briandorey/10Mhz-Frequency-Standard-Distribution-Project/README.md

# 10Mhz Frequency Standard-Distribution Project
10Mhz Frequency Standard Distribution Project pcb files and firmware files.

PCB files are in Diptrace format.

Full details for this project are on my blog [http://www.briandorey.com/post/10Mhz-Frequency-Standard-Distribution-Project](http://www.briandorey.com/post/10Mhz-Frequency-Standard-Distribution-Project)
