briandorey/10Mhz-Frequency-Standard-Distribution-Project/Schematic and PCB/10Mhz Frequency Standard Bom.xlsx

Sheet: power board bom
RefDes | Value | Name | Part | Pattern | Quantity
C1 | 0.33uF |  | Part 1 | CAPAE-4.3x4.3h5.4 | 1 | http://uk.farnell.com/wurth-elektronik/865090640003/cap-alu-elec-0-33uf-50v-radial/dp/2466392
C2, C5, C6, C7, C8, C9 | 100nF |  | Part 1 | CAP_0603 | 6 | http://uk.farnell.com/tdk/cga3e2x8r1e104k080aa/cap-mlcc-x8r-100nf-25v-0603/dp/2210887
C3 | 2uF |  | Part 1 | CAPAE-4.3x4.3h5.4 | 1 | http://uk.farnell.com/wurth-elektronik/865060640002/cap-alu-elec-2-2uf-50v-radial/dp/2466227
C4 | 1uF |  | Part 1 | CAPAE-4.3x4.3h5.4 | 1 | http://uk.farnell.com/wurth-elektronik/865080640001/cap-alu-elec-1uf-50v-radial-can/dp/2466328
C10 | 10uF | C2012X5R1E106K125AB | Part 1 | CAP_0805 | 1 | http://uk.farnell.com/tdk/c2012x5r1e106k125ab/cap-mlcc-x5r-10uf-25v-0805/dp/2346927
C11 | 1uF |  | Part 1 | CAP_0805 | 1 | http://uk.farnell.com/kemet/c0805c105k3ractu/cap-mlcc-x7r-1uf-25v-0805/dp/2395779
D1, D2, D3, D4 |  | 1SR154-400TE25 | Part 1 | SOD-106 | 4 | http://uk.farnell.com/rohm/1sr154-400te25/diode-standard-1a-400v/dp/1525432
D5 | 3mm Round Bi-Color | LED(BI)-3R | Part 1 | LED(BI)-3R | 1 | http://uk.farnell.com/kingbright/l-5a9egw-12-3sf/led-red-grn-25-50mcd-th/dp/2449762
F1 |  | FUSE | Part 1 | Fuse Holder | 1
Q1 | FZT600 | NPNDARL | Part 1 | SOT223-4 | 1 | http://uk.farnell.com/diodes-inc/fzt600/darlington-transistor-sot-223/dp/9526650
R1 | 270R |  | Part 1 | RES_0603 | 1
R2, R3 | 220R |  | Part 1 | RES_0603 | 2
R4 | 10K |  | Part 1 | RES_0603 | 1
U1 |  | UA7805 | Part 1 | TO-220V | 1 | http://uk.farnell.com/texas-instruments/ua7805ckct/regulator-ldo-fixed-5v-to-220/dp/2323602
U2 |  | UA7905 | Part 1 | TO-220V | 1 | http://uk.farnell.com/texas-instruments/ua7905ckcs/ic-negative-volt-regulator-5v/dp/2342562
U4 |  | PIC12F1822_SN | Part 1 | SOIC-8/150mil | 1
U5 |  | TMP36GT9Z | Part 1 | TO-92 | 1
U6 |  | LM2937IMP-12/NOPB | Part 1 | SOT223-4 | 1 | http://uk.farnell.com/texas-instruments/lm2937imp-12-nopb/ic-v-reg-linear-12v-smd/dp/1469069
 |  |  |  |  | 40

Sheet: low pass filter board
RefDes | Value | Name | Part | Pattern | Quantity
C1, C2, C3, C4 | 100nF |  | Part 1 | CAP_0603 | 4 | http://uk.farnell.com/tdk/cga3e2x8r1e104k080aa/cap-mlcc-x8r-100nf-25v-0603/dp/2210887
J2 |  | U.FL | Part 1 | U.FL-R-SMT-1 | 1
R1 | 10K | 3296P-1-103LF | Part 1 | 3296P | 1 | http://uk.farnell.com/bourns/3296p-1-103lf/trimmer-25-turn-10k/dp/9353046?ost=3296P-1-103LF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
R2, R6 | 523R |  | Part 1 | RES_0603 | 2 | http://uk.farnell.com/te-connectivity/cpf0603b523re1/res-thin-film-523r-0-1-0-063w/dp/2331268
R3, R7 | 402R |  | Part 1 | RES_0603 | 2 | http://uk.farnell.com/te-connectivity/cpf0603b402re1/res-thin-film-402r-0-1-0-063w/dp/2331206
R4 | 1K |  | Part 1 | RES_0603 | 1 | http://uk.farnell.com/panasonic-electronic-components/era3aeb102v/res-thin-film-1k-0-1-0-1w-0603/dp/1577605
R5, R8, R9 | 50R |  | Part 1 | RES_0603 | 3 | http://uk.farnell.com/vishay/crcw060350r0fkea/res-thick-film-50r-1-0-1w-0603/dp/2112878
T1, T2 |  | WBC16-1T | Part 1 | WBC Series | 2 | https://uk.farnell.com/coilcraft/wbc16-1tlc/wideband-transformer-1-16-0-6/dp/2458093
U1 | L77TSEH09SOL2 | FE-5680A | Part 1 | DB9F | 1
U2 |  | LT6600CS8-15 | Part 1 | SOIC-8/150mil | 1
U3 |  | LM7171 | Part 1 | SOIC-8/150mil | 1 | http://uk.farnell.com/texas-instruments/lm7171aim-nopb/ic-op-amp-single-smd/dp/1468932
 |  |  |  |  | 21

Sheet: distribution board
RefDes | Value | Name | Part | Pattern | Quantity
C3, C4, C11, C16, C18, C20, C21, C22, C23, C24, C27, C29, C30, C31, C33, C35, C36, C37, C38, C39, C40 | 100nF |  | Part 1 | CAP_0603 | 21 | http://uk.farnell.com/tdk/cga3e2x8r1e104k080aa/cap-mlcc-x8r-100nf-25v-0603/dp/2210887
C7, C15 | 10nF |  | Part 1 | CAP_0603 | 2
C8, C12, C14 | 1uF |  | Part 1 | CAP_0805 | 3 | http://uk.farnell.com/kemet/c0805c105k3ractu/cap-mlcc-x7r-1uf-25v-0805/dp/2395779
D2 |  | HSMS-281C | Part 1 | SOT23 | 1 | http://uk.farnell.com/broadcom-limited/hsms-281c-blkg/diode-schottk-gp-ln-20v-sot-323/dp/1843071
J1, J3, J4, J5, J6, J7, J9, J10, J11 |  | SMA | Part 1 | SMA | 9
J2, J8, J12, J13 |  | U.FL | Part 1 | U.FL-R-SMT-1 | 4
R1, R6, R9, R12, R15, R19, R21 | 10K |  | Part 1 | RES_0603 | 7 | http://uk.farnell.com/panasonic-electronic-components/era3aeb103v/res-thin-film-10k-0-1-0-1w-0603/dp/1577619
R2 | 9.09K |  | Part 1 | RES_0603 | 1 | http://uk.farnell.com/te-connectivity/rp73pf1j9k09btdf/res-thin-film-9k09-0-1-0-166w/dp/2116780
R3, R4, R7, R10, R13, R16, R20, R22, R24, R25, R28, R30 | 50R |  | Part 1 | RES_0603 | 12 | http://uk.farnell.com/vishay/crcw060350r0fkea/res-thick-film-50r-1-0-1w-0603/dp/2112878
R26, R29 | 100R |  | Part 1 | RES_0603 | 2 | http://uk.farnell.com/te-connectivity/rp73pf1j100rbtdf/res-thin-film-100r-0-1-0-166w/dp/2116572
R27 | 604R |  | Part 1 | RES_0603 | 1 | http://uk.farnell.com/te-connectivity/cpf0603b604re1/res-thin-film-604r-0-1-0-063w/dp/2331308
T1 |  | WBC16-1T | Part 1 | WBC Series | 1 | https://uk.farnell.com/coilcraft/wbc16-1tlc/wideband-transformer-1-16-0-6/dp/2458093
U3 |  | SN74LVC1G06 | Part 1 | SOT23-5 | 1 | http://uk.farnell.com/texas-instruments/sn74lvc1g06dckt/logic-inverter-single-1input-5sc70/dp/1741231
U4 |  | TLC555CD | Part 1 | SOIC-8/150mil | 1 | http://uk.farnell.com/texas-instruments/tlc555cdr/ic-timer-smd-soic8-555/dp/8454426
U6 |  | TPS79530DCQ | Part 1 | SOT223-6 | 1 | http://uk.farnell.com/texas-instruments/tps79530dcq/ic-v-reg-ldo-0-5a-3-0v-smd-79530/dp/1135418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
U9, U11, U14 |  | LM7171 | Part 1 | SOIC-8/150mil | 3 | http://uk.farnell.com/texas-instruments/lm7171aim-nopb/ic-op-amp-single-smd/dp/1468932
U16, U18 |  | SN74LVC2G17 | Part 1 | SOT23-6 | 2 | http://uk.farnell.com/texas-instruments/sn74lvc2g17dbvr/ic-schmitt-trigger-buff-2bit-6sot/dp/1470776
U17 |  | LTC6957-3 | Part 1 | MSOP-12 | 1
 |  |  |  |  | 74
