briandorey/10Mhz-Frequency-Standard-Distribution-Project/(list of files, cad)

Other CAD files:
Firmware/10MHz Frequency Standard 2.0.X/dist/default/production/10MHz_Frequency_Standard_2.0.X.production.obj
