briandorey/10Mhz-Frequency-Standard-Distribution-Project/Schematic and PCB/10Mhz Frequency Standard - Power Board.pdf

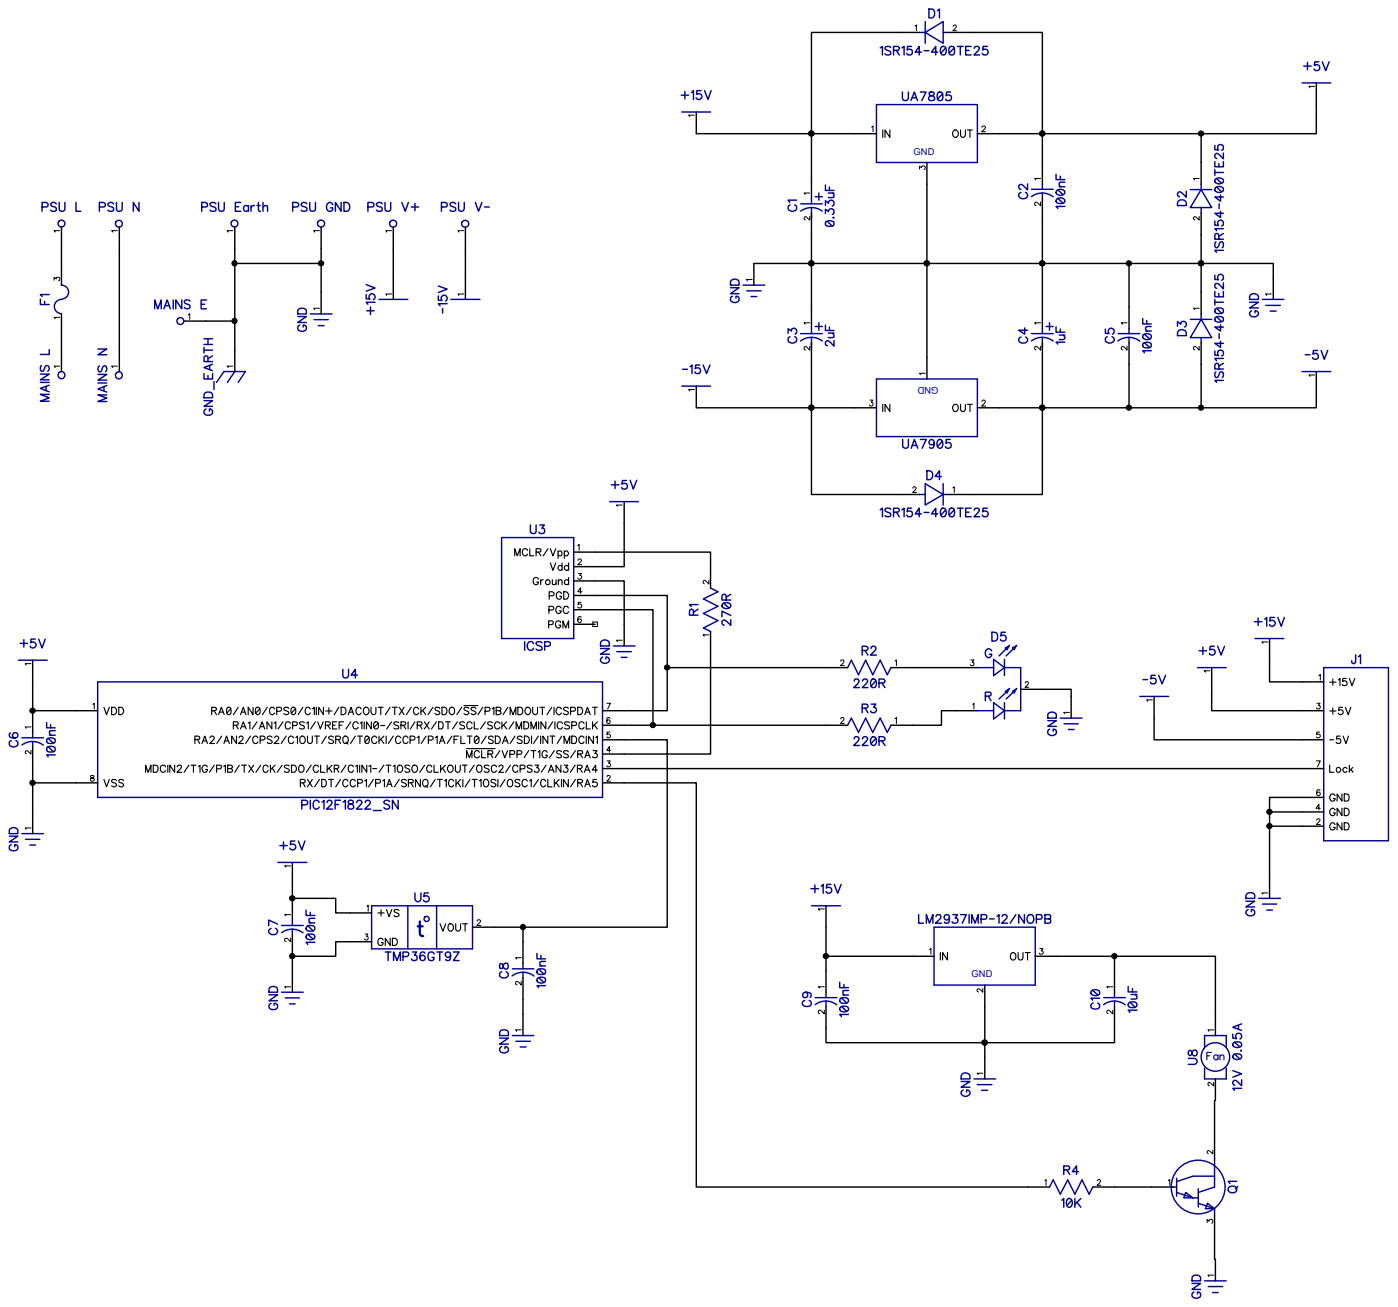
[picture p1: page 1]
GND GND; GND
