briandorey/10Mhz-Frequency-Standard-Distribution-Project/Schematic and PCB/10Mhz Frequency Standard - Distribution Board.pdf

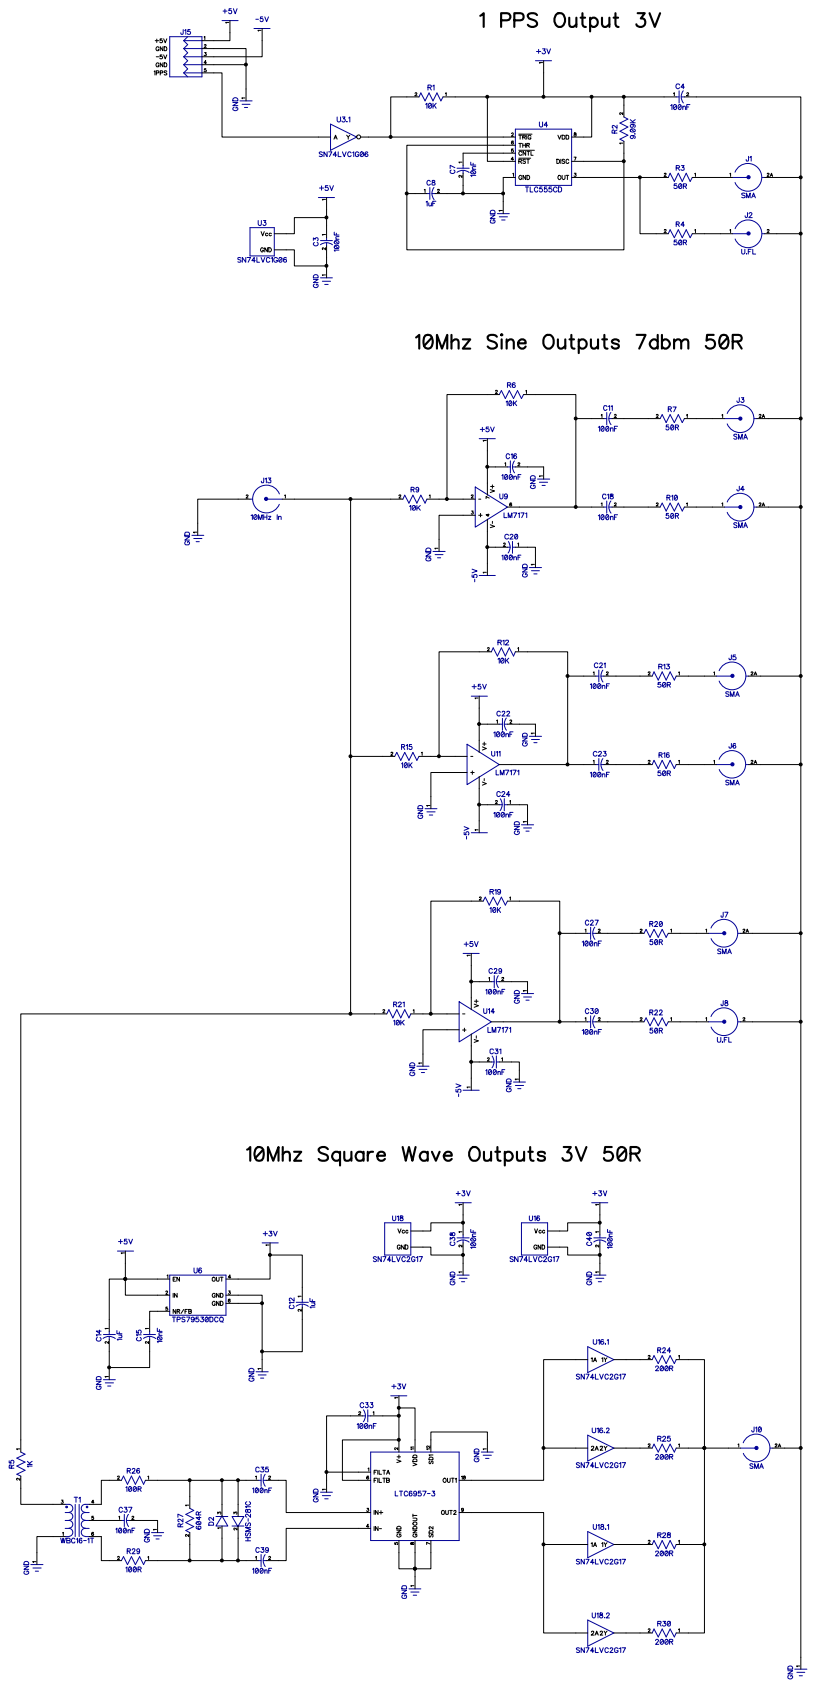
[picture p2: page 1]
