briandorey/10Mhz-Frequency-Standard-Distribution-Project/Schematic and PCB/10Mhz Frequency Standard - Low Pass Filter Board.pdf

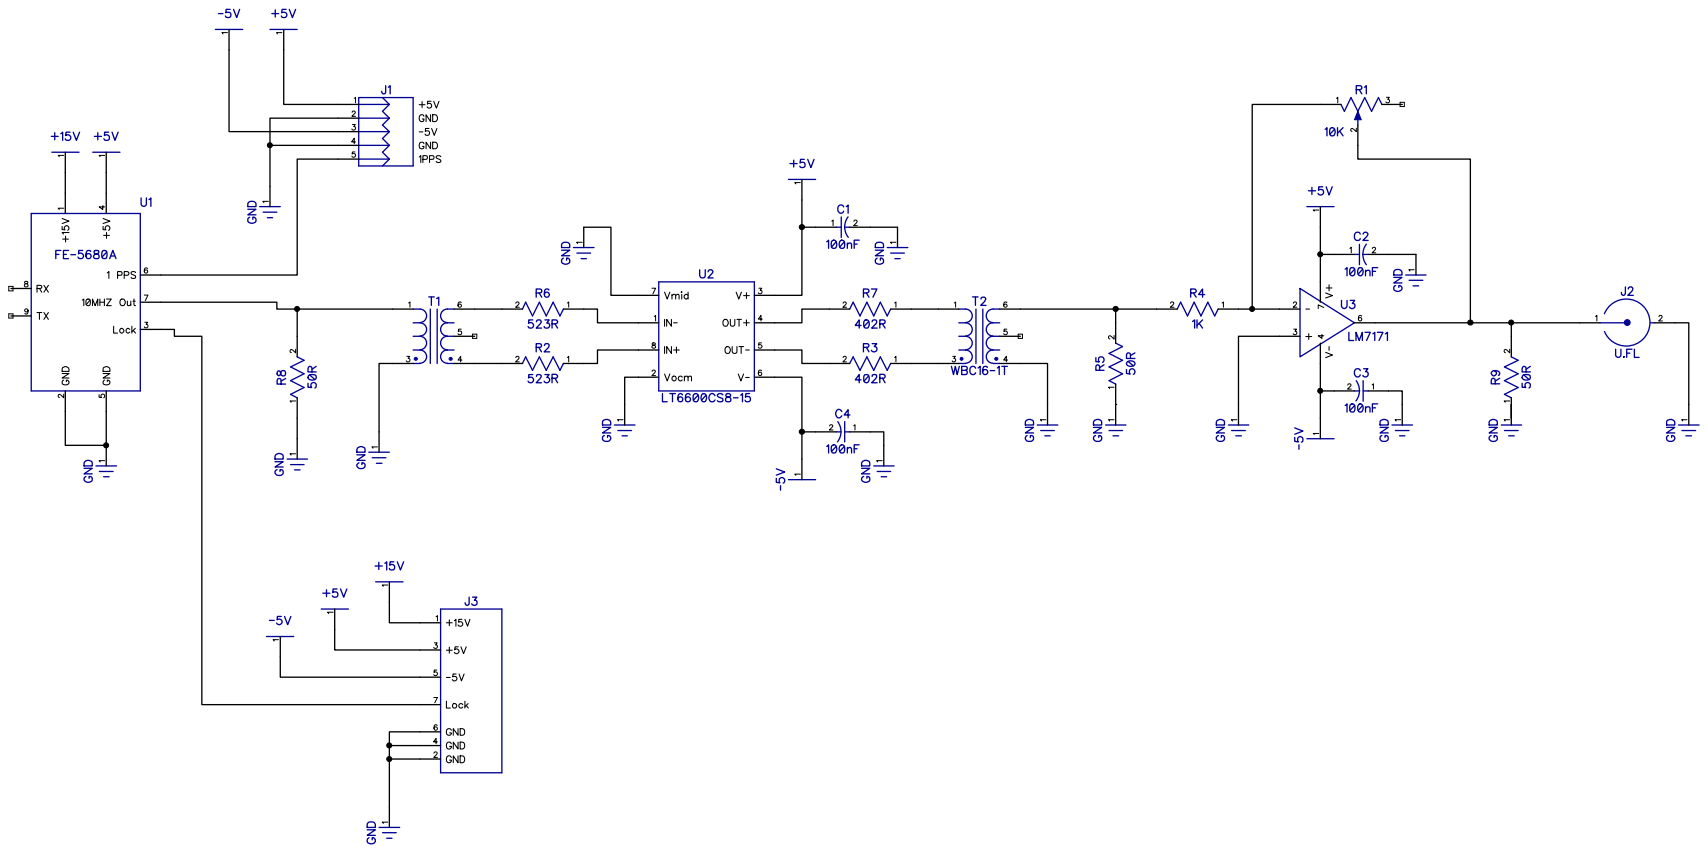
[picture p3: page 1]
