briandorey/10Mhz-Frequency-Standard-Distribution-Project/(list of files, drawings)

Other design files:
Schematic and PCB/10Mhz Frequency Standard - Distribution Board.dch
Schematic and PCB/10Mhz Frequency Standard - Distribution Board.dip
Schematic and PCB/10Mhz Frequency Standard - Low Pass Filter Board.dch
Schematic and PCB/10Mhz Frequency Standard - Low Pass Filter Board.dip
Schematic and PCB/10Mhz Frequency Standard - Power Board.dch
Schematic and PCB/10Mhz Frequency Standard - Power Board.dip
