briandorey/10Mhz-Frequency-Standard-Distribution-Project/(commit log)

2016-09-04 Upload of project files
    [10MHz_Frequency_Standard_2.0.X.production.obj, 10Mhz Frequency Standard - Distribution Board.dch, 10Mhz Frequency Standard - Distribution Board.dip, 10Mhz Frequency Standard - Low Pass Filter Board.dch, 10Mhz Frequency Standard - Low Pass Filter Board.dip, 10Mhz Frequency Standard - Power Board.dch, 10Mhz Frequency Standard - Power Board.dip]
2022-11-30 Added BOM file
    [10Mhz Frequency Standard Bom.xlsx]
